iorodeo/nano_ssr/dc_only/nano_ssr.pdf

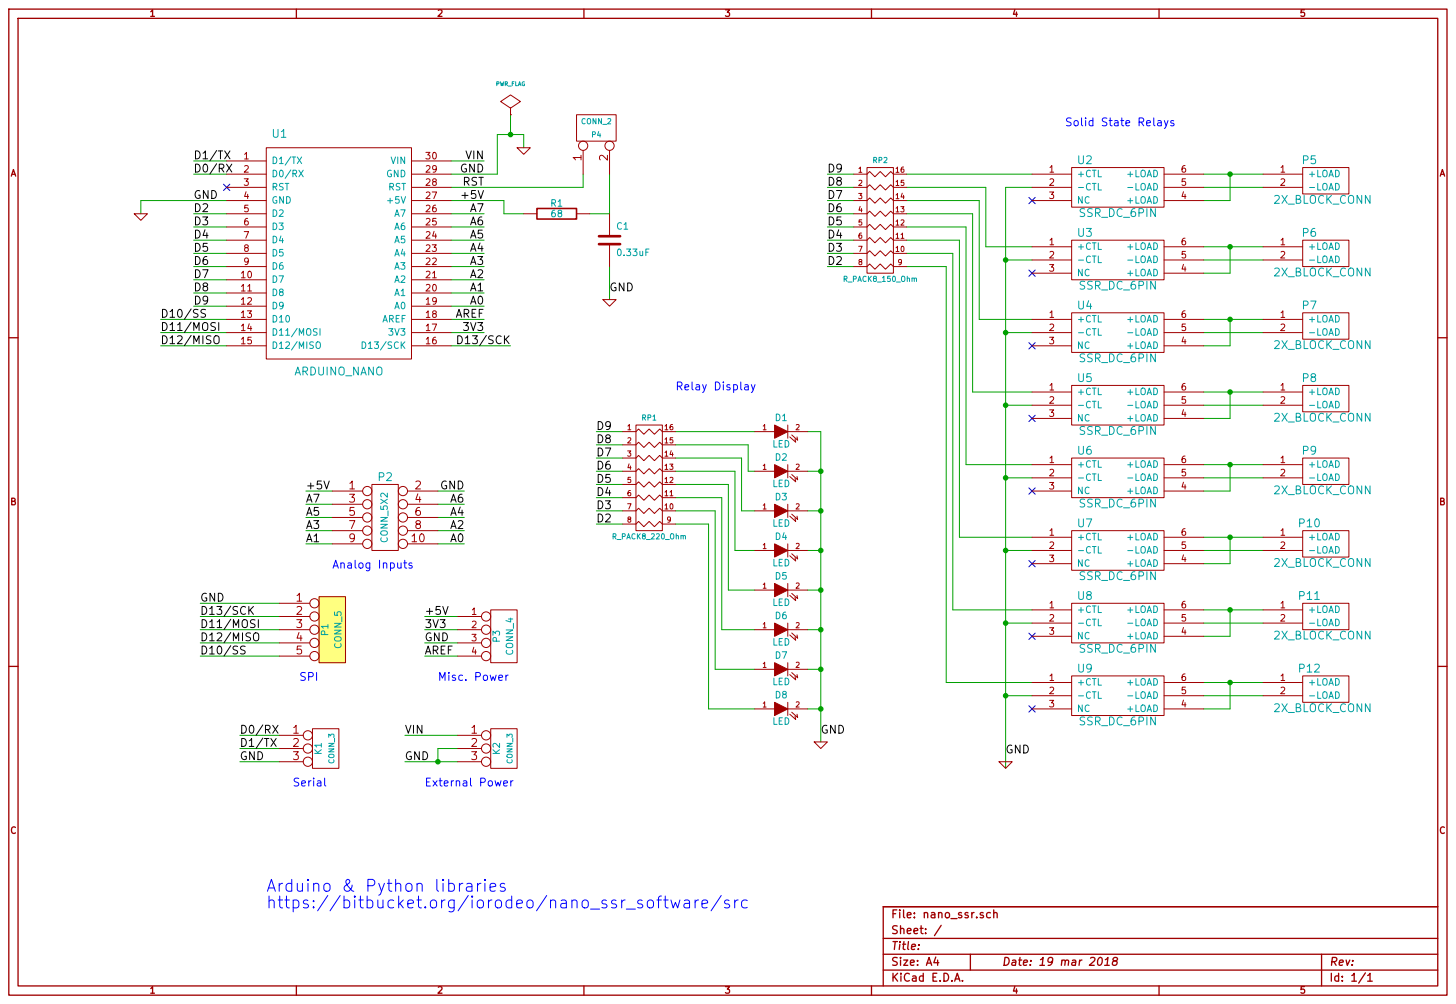
[picture p1: page 1]

Arduino & Python libraries
https://bitbucket.org/iorodeo/nano_ssr_software/src

Id: 1/1 Title: File: nano_ssr.sch
Sheet: /
