iorodeo/nano_ssr/ac_dc/nano_ssr.pdf

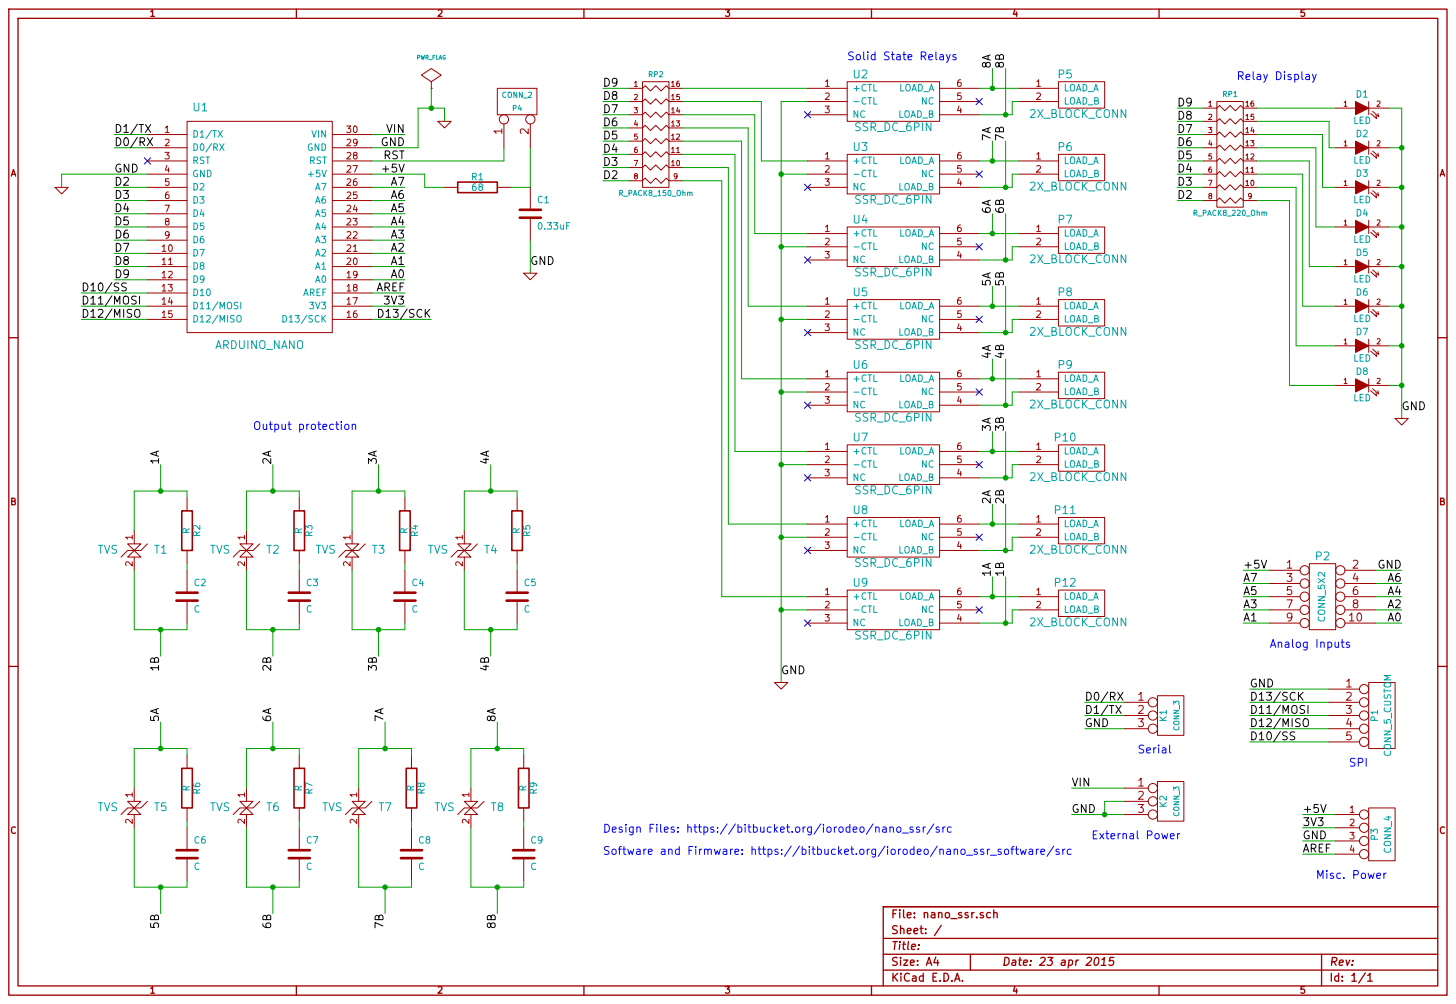
[picture p2: page 1]

Design Files: https://bitbucket.org/iorodeo/nano_ssr/src
Software and Firmware: https://bitbucket.org/iorodeo/nano_ssr_software/src

Id: 1/1 Title: File: nano_ssr.sch
Sheet: /
