iorodeo/nano_ssr/(list of files, drawings)

Other design files:
ac_dc/nano_ssr.dsn
