iorodeo/nano_ssr/ac_dc/nano_ssr.sch

## KiCad design ac_dc/nano_ssr.sch (2015-04-23, an earlier design)

Schematic: nano_ssr.sch

Parts:
C1: 0.33uF
C2, C3, C4, C5, C6, C7, C8, C9: C
D1, D2, D3, D4, D5, D6, D7, D8: LED
K1, K2: CONN_3
P1: CONN_5_CUSTOM
P2: CONN_5X2
P3: CONN_4
P4: CONN_2
P5, P6, P7, P8, P9, P10, P11, P12: 2X_BLOCK_CONN
R1: 68
R2, R3, R4, R5, R6, R7, R8, R9: R
RP1: R_PACK8_220_Ohm
RP2: R_PACK8_150_Ohm
T1, T2, T3, T4, T5, T6, T7, T8: TVS
U1: ARDUINO_NANO
U2, U3, U4, U5, U6, U7, U8, U9: SSR_DC_6PIN

Notes on the sheet:
Solid State Relays
Relay Display
External Power
Serial
Misc. Power
SPI
Analog Inputs
Output protection
