iorodeo/nano_ssr/dc_only/nano_ssr.sch

## KiCad design dc_only/nano_ssr.sch (2018-03-19, an earlier design)


Parts:
C1: 0.33uF
D1, D2, D3, D4, D5, D6, D7, D8: LED
K1, K2: CONN_3
P1: CONN_5
P2: CONN_5X2
P3: CONN_4
P4: CONN_2
P5, P6, P7, P8, P9, P10, P11, P12: 2X_BLOCK_CONN
R1: 68
RP1: R_PACK8_220_Ohm
RP2: R_PACK8_150_Ohm
U1: ARDUINO_NANO
U2, U3, U4, U5, U6, U7, U8, U9: SSR_DC_6PIN

Connections:
3V3: P3.2, U1.17 (3V3)
+5V: P2.1, P3.1, R1.1, U1.27 (+5V)
A0: P2.10, U1.19 (A0)
A1: P2.9, U1.20 (A1)
A2: P2.8, U1.21 (A2)
A3: P2.7, U1.22 (A3)
A4: P2.6, U1.23 (A4)
A5: P2.5, U1.24 (A5)
A6: P2.4, U1.25 (A6)
A7: P2.3, U1.26 (A7)
AREF: P3.4, U1.18 (AREF)
D0/RX: K1.1, U1.2 (D0/RX)
D1/TX: K1.2 (PM), U1.1 (D1/TX)
D2: RP1.8, RP2.8, U1.5 (D2)
D3: RP1.7, RP2.7, U1.6 (D3)
D4: RP1.6, RP2.6, U1.7 (D4)
D5: RP1.5, RP2.5, U1.8 (D5)
D6: RP1.4, RP2.4, U1.9 (D6)
D7: RP1.3, RP2.3, U1.10 (D7)
D8: RP1.2, RP2.2, U1.11 (D8)
D9: RP1.1, RP2.1, U1.12 (D9)
D10/SS: P1.5, U1.13 (D10)
D11/MOSI: P1.3, U1.14 (D11/MOSI)
D12/MISO: P1.4, U1.15 (D12/MISO)
D13/SCK: P1.2, U1.16 (D13/SCK)
GND: C1.2, D1.2 (K), D2.2 (K), D3.2 (K), D4.2 (K), D5.2 (K), D6.2 (K), D7.2 (K), D8.2 (K), K1.3, K2.2 (PM), K2.3, P1.1, P2.2, P3.3, U1.4 (GND), U1.29 (GND), U2.2 (-CTL), U3.2 (-CTL), U4.2 (-CTL), U5.2 (-CTL), U6.2 (-CTL), U7.2 (-CTL), U8.2 (-CTL), U9.2 (-CTL)
unnamed: C1.1, P4.2 (PM), R1.2
unnamed: D1.1 (A), RP1.16 (R1)
unnamed: D2.1 (A), RP1.15 (R2)
unnamed: D3.1 (A), RP1.14 (R3)
unnamed: D4.1 (A), RP1.13 (R4)
unnamed: D5.1 (A), RP1.12 (R5)
unnamed: D6.1 (A), RP1.11 (R6)
unnamed: D7.1 (A), RP1.10 (R7)
unnamed: D8.1 (A), RP1.9 (R8)
unnamed: P5.1 (+LOAD), U2.4 (+LOAD), U2.6 (+LOAD)
unnamed: P5.2 (-LOAD), U2.5 (-LOAD)
unnamed: P6.1 (+LOAD), U3.4 (+LOAD), U3.6 (+LOAD)
unnamed: P6.2 (-LOAD), U3.5 (-LOAD)
unnamed: P7.1 (+LOAD), U4.4 (+LOAD), U4.6 (+LOAD)
unnamed: P7.2 (-LOAD), U4.5 (-LOAD)
unnamed: P8.1 (+LOAD), U5.4 (+LOAD), U5.6 (+LOAD)
unnamed: P8.2 (-LOAD), U5.5 (-LOAD)
unnamed: P9.1 (+LOAD), U6.4 (+LOAD), U6.6 (+LOAD)
unnamed: P9.2 (-LOAD), U6.5 (-LOAD)
unnamed: P10.1 (+LOAD), U7.4 (+LOAD), U7.6 (+LOAD)
unnamed: P10.2 (-LOAD), U7.5 (-LOAD)
unnamed: P11.1 (+LOAD), U8.4 (+LOAD), U8.6 (+LOAD)
unnamed: P11.2 (-LOAD), U8.5 (-LOAD)
unnamed: P12.1 (+LOAD), U9.4 (+LOAD), U9.6 (+LOAD)
unnamed: P12.2 (-LOAD), U9.5 (-LOAD)
unnamed: RP2.9 (R8), U9.1 (+CTL)
unnamed: RP2.10 (R7), U8.1 (+CTL)
unnamed: RP2.11 (R6), U7.1 (+CTL)
unnamed: RP2.12 (R5), U6.1 (+CTL)
unnamed: RP2.13 (R4), U5.1 (+CTL)
unnamed: RP2.14 (R3), U4.1 (+CTL)
unnamed: RP2.15 (R2), U3.1 (+CTL)
unnamed: RP2.16 (R1), U2.1 (+CTL)
RST: P4.1, U1.28 (RST)
VIN: K2.1, U1.30 (VIN)

Notes on the sheet:
Solid State Relays
Relay Display
External Power
Serial
Misc. Power
SPI
Analog Inputs
