iorodeo/nano_ssr/(commit log)

2010-11-30 Project creation.
    [$savepcb.brd, nano_ssr.brd, nano_ssr.sch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]
2012-01-05 Modified power jack through hole sizes.
    [nano_ssr.brd]
2012-02-14 Modified board and plotted new gerber files v1p1
    [nano_ssr.brd]
2012-02-14 Added gerber files for v1p1. Previous hg push did not add these files.
    [nano_ssr-Component.gtl, nano_ssr-Copper.gbl, nano_ssr-Mask_Back.gbs, nano_ssr-Mask_Front.gts, nano_ssr-PCB_Edges.gbr, nano_ssr-SilkS_Back.gbo, nano_ssr-SilkS_Front.gto, nano_ssr.drl]
2012-06-04 Modified resistor annotation.
    [nano_ssr.sch]
2012-06-04 Added svg of schematic.
2013-07-06 Moved design to dc_only directory
    [$savepcb.brd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]
2013-07-07 Created ac/dc version of the ssr shield for arduino nano.
    [$savepcb.brd, nano_ssr.brd, nano_ssr.dsn, nano_ssr.kicad_pcb, nano_ssr.sch]
2013-07-08 Fixed issure with led pads. Added additional anotation to sild screen.
    [nano_ssr-B_Cu.gbl, nano_ssr-B_Mask.gbs, nano_ssr-B_SilkS.gbo, nano_ssr-Edge_Cuts.gbr, nano_ssr-F_Cu.gtl, nano_ssr-F_Mask.gts, nano_ssr-F_SilkS.gto, nano_ssr.drl]
2015-04-07 Created v1.1 and new gerber files for ac_dc version. Modified filled zones slightly - decreased spoke length.
    [nano_ssr-B_Mask.gbs, nano_ssr-B_SilkS.gbo, nano_ssr-Component.gtl, nano_ssr-Copper.gbl, nano_ssr-Edge_Cuts.gbr, nano_ssr-F_Mask.gts, nano_ssr-F_SilkS.gto, nano_ssr.drl]
2015-04-23 Added pdf of schematic.
    [nano_ssr.sch]
2016-02-01 Modified schematic pdfs.
2016-03-23 Fixed library issue with dc_only version.
    [nano_ssr.sch]
2016-07-06 Updated BOM's so that all parts are from digikey (accept for the arduino nano).
2016-07-14 Added zip of v1.1 gerber files.
2017-10-24 Added gerber files for v1.2. Fixed issue with back solder mask.
    [nano_ssr-B_Mask.gbs, nano_ssr-B_SilkS.gbo, nano_ssr-Component.gtl, nano_ssr-Copper.gbl, nano_ssr-Edge_Cuts.gbr, nano_ssr-F_Mask.gts, nano_ssr-F_SilkS.gto, nano_ssr.drl]
2017-10-25 Fixed additional issue with missing solder mask for dc version of nano ssr.
    [nano_ssr-B_Mask.gbs, nano_ssr-B_SilkS.gbo, nano_ssr-Component.gtl, nano_ssr-Copper.gbl, nano_ssr-Edge_Cuts.gbr, nano_ssr-F_Mask.gts, nano_ssr-F_SilkS.gto, nano_ssr.drl]
2018-03-08 Fixed part name in dc_dc BOM.
2018-03-19 Added link to Arduino and Python libraries on schematic.
    [nano_ssr.sch]
